stark-03/CapSight/docs/Build_Steps_3D.html

CapSight · cap camera build

# ESP32-CAM build, step by step in 3D

Each step plays as an animation. Drag to rotate, pinch or scroll to zoom, and use the slider to scrub through a step. Steps 1–4 use the parts you have now; steps 5–6 preview Phase B.

drag to rotate · scroll to zoom

◀ Prev Replay 1 / 6 Next ▶

Models are simplified and not exactly to scale. Always match the pin names printed on your own boards.
