stark-03/CapSight/docs/SRS_Camera_Navigation.pdf

SOFTWARE REQUIREMENTS SPECIFICATION · IEEE 830 STRUCTURE

# Camera-Based Navigation System for Visually Impaired People

A camera on a cap streams to an Android phone. The phone detects obstacles, estimates distance, picks a safe direction, and speaks instructions through Bluetooth earphones.

Version | 1.0 (draft for review)
Date | 29 September 2026
Institution | Dept. of CSE, Angadi Institute of Technology and Management, Belagavi (VTU)
Team | Aishwarya Kumar Telasinge (2AG23CS007) · Anuja Sutar (2AG23CS016) · Aishwarya Channashetti (2AG23CS006) · Chandrika Bannimatti (2AG23CS032)
Guide | Prof. Avanti Patil

### Supersedes Ceiling-camera + BLE design (Phase-2 report)

# 1 Introduction

## 1.1 Purpose

This document specifies the requirements for a wearable navigation aid. It is written for the project team, the project guide and the evaluators. It is the reference for design, implementation and acceptance testing.

## 1.2 Scope

The system has two parts:

Cap unit. A small camera board mounted on the front of a cap. It captures the scene in front of the user and streams it over Wi-Fi.
Android application. It receives the frames and runs all AI processing on the phone: object detection, obstacle detection, distance estimation and path analysis. It then decides a direction and speaks it through the phone speaker or Bluetooth earphones.

The system works indoors and outdoors at walking speed, with no internet connection and no building infrastructure. It supplements the white cane and does not replace it. Turn-by-turn route navigation (for example “go to Room 204”) is out of scope for this version.

## 1.3 Definitions and abbreviations

TERM | MEANING
Cap unit | The camera board, battery and optional IMU mounted on the cap.

TERM | MEANING
Walking corridor | The strip of the image directly ahead of the user, about shoulder width (0.8 m) at ground level.
Obstacle | Any object in or near the walking corridor that the user could collide with or trip over.
Zone | One of three vertical sectors of the view: left, centre, right.
Pitch | The up/down tilt of the user’s head, and therefore of the camera.
MJPEG | Motion JPEG. A video stream sent as a sequence of JPEG images over HTTP.
TFLite | TensorFlow Lite (LiteRT). The on-device inference runtime for Android.
YOLOv8n | The nano variant of the YOLOv8 object detector, already used in Phase 2.
TTS | Text-to-speech.
IMU | Inertial measurement unit (accelerometer and gyroscope), e.g. MPU6050.
Must / Should / Could | MoSCoW priority. Must is required for the demo. Should is expected but can be cut if time runs out. Could is an enhancement.

## 1.4 References

IEEE Std 830-1998, Recommended Practice for Software Requirements Specifications.
Project Phase-2 report: Bluetooth Low Energy and Surveillance Camera-based Navigation System for Visually Impaired People, AITM Belagavi, 2025–26.
Phase-2 source code: blenav/ (in particular guidance.py , egocentric.py , voice.py ) and esp32_cam_ap/ firmware.
Ultralytics YOLOv8 documentation (TFLite export). Android TextToSpeech API documentation.

# 2 Overall description

## 2.1 Product perspective

This is the third iteration of the project. Phase 2 used a fixed ceiling camera to locate the user and BLE to identify them, with processing on a laptop. Its “first-person mode” showed that a camera carried by the user works as well. This version adopts that first-person design as the main product and moves all processing onto the phone, so the user carries the whole system.

The following Phase-2 components are reused in adapted form:

Navigation policy ( guidance.decide() , 40 unit tests): ported to Kotlin with the same priority levels. Size-based distance model ( egocentric.py , 56 unit tests): object height and width tables, reused as-is.

Voice priority and cooldown rules ( voice.py ): re-implemented on Android TTS.
ESP32-CAM access-point firmware ( esp32_cam_ap.ino ): reused with the pin map changed for the new board.

## 2.2 Product functions

1. Capture the scene in front of the user from a cap-mounted camera.
2. Stream frames to the Android phone over a direct Wi-Fi link.
3. Detect known objects (people, chairs, tables, doors, vehicles, stairs and others).
4. Detect obstacles in the walking corridor, including ones the detector cannot name.
5. Estimate the distance to each obstacle in metres.
6. Analyse the path ahead and find the clearest direction.
7. Decide an instruction and a safety alert level.
8. Speak short instructions through the phone or Bluetooth earphones.

## 2.3 User classes

USER | DESCRIPTION | WHAT THEY NEED
Primary user | A blind or low-vision person. May not be able to see the phone screen at all. | Start, stop and use the system entirely by voice, touch and hardware buttons. Short, clear spoken instructions.
Helper | A family member, caregiver or instructor who sets the system up. | Pair the cap, set the user’s height and the camera angle, and adjust voice settings.
Developer / evaluator | The project team and examiners. | A debug view showing detections, distances and decisions live, plus logs.

## 2.4 Operating environment

Phone: Android 10 (API 29) or later, 4 GB RAM or more, a mid-range chipset (Snapdragon 6/7 series, Dimensity 700 or better).
Cap unit: ESP32-S3 camera board with OV2640 sensor, 2.4 GHz Wi-Fi, powered by a 3.7 V LiPo battery. Audio: the phone speaker or any Bluetooth earphones (A2DP). Open-ear or bone-conduction earphones are recommended.
Surroundings: indoor corridors, rooms and campus pathways, in daylight or normal indoor lighting.

## 2.5 Design and implementation constraints

All AI processing runs on the phone. No cloud service and no laptop in the loop.
The app is written in Kotlin with Android Studio. Models run on TensorFlow Lite with the GPU or NNAPI delegate where available.
The cap unit must be light and small enough to wear comfortably (target ≤ 100 g including battery).

## 2.6 Assumptions and dependencies

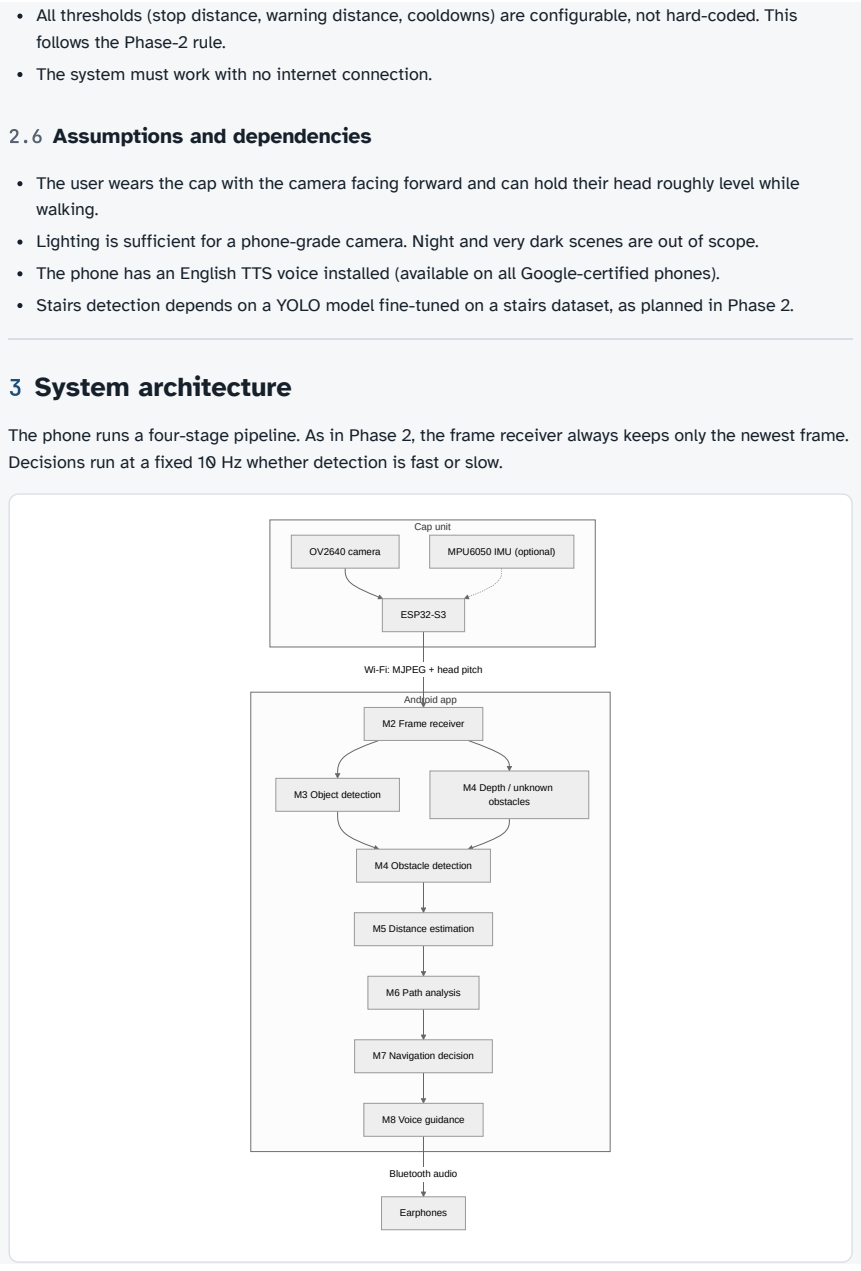
[picture p29: page 4]
3 System architecture; Android app; Cap unit; Bluetooth audio; OV2640 camera; ESP32-S3; MPU6050 IMU (optional); M2 Frame receiver; M3 Object detection; M4 Depth / unknown; obstacles; M4 Obstacle detection; M5 Distance estimation; M6 Path analysis; M7 Navigation decision; M8 Voice guidance; Earphones

All thresholds (stop distance, warning distance, cooldowns) are configurable, not hard-coded. This
follows the Phase-2 rule.
The system must work with no internet connection.

The user wears the cap with the camera facing forward and can hold their head roughly level while
walking.
Lighting is sufficient for a phone-grade camera. Night and very dark scenes are out of scope.
The phone has an English TTS voice installed (available on all Google-certified phones).
Stairs detection depends on a YOLO model fine-tuned on a stairs dataset, as planned in Phase 2.

The phone runs a four-stage pipeline. As in Phase 2, the frame receiver always keeps only the newest frame.
Decisions run at a fixed 10 Hz whether detection is fast or slow.

Wi-Fi: MJPEG + head pitch

## 3.1 Modules

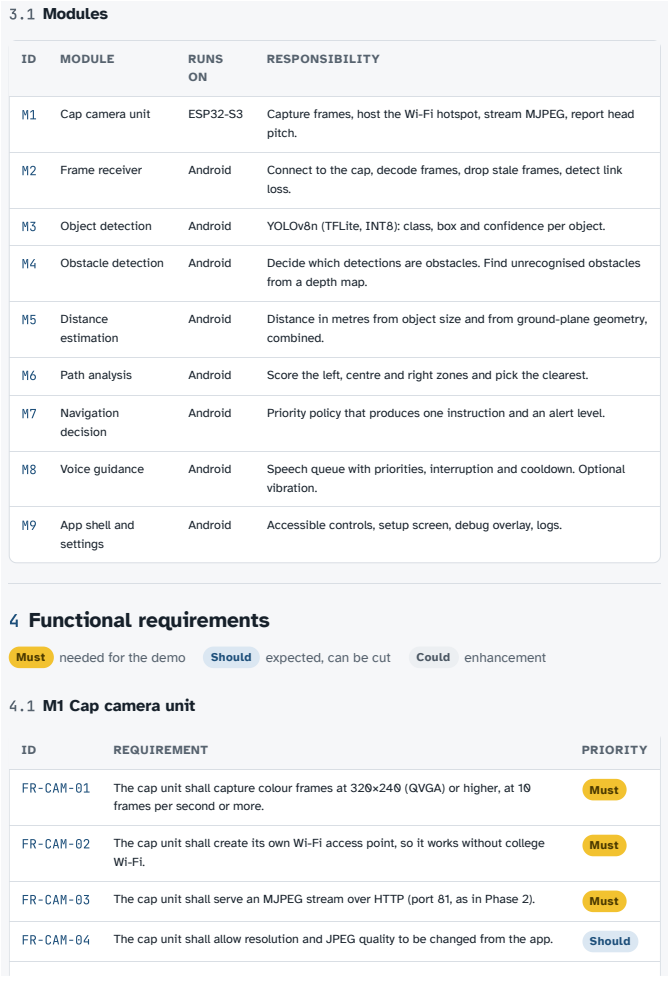
[picture p30: page 5]
MODULE; RUNS; RESPONSIBILITY; Cap camera unit; ESP32-S3; Capture frames, host the Wi-Fi hotspot, stream MJPEG, report head; pitch.; Frame receiver; Android; Connect to the cap, decode frames, drop stale frames, detect link; loss.; Object detection; YOLOv8n (TFLite, INT8): class, box and confidence per object.; Obstacle detection; Decide which detections are obstacles. Find unrecognised obstacles; Distance; estimation; Distance in metres from object size and from ground-plane geometry,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

from a depth map.

4.1 M1 Cap camera unit

frames per second or more.

## 4.2 M2 Frame receiver

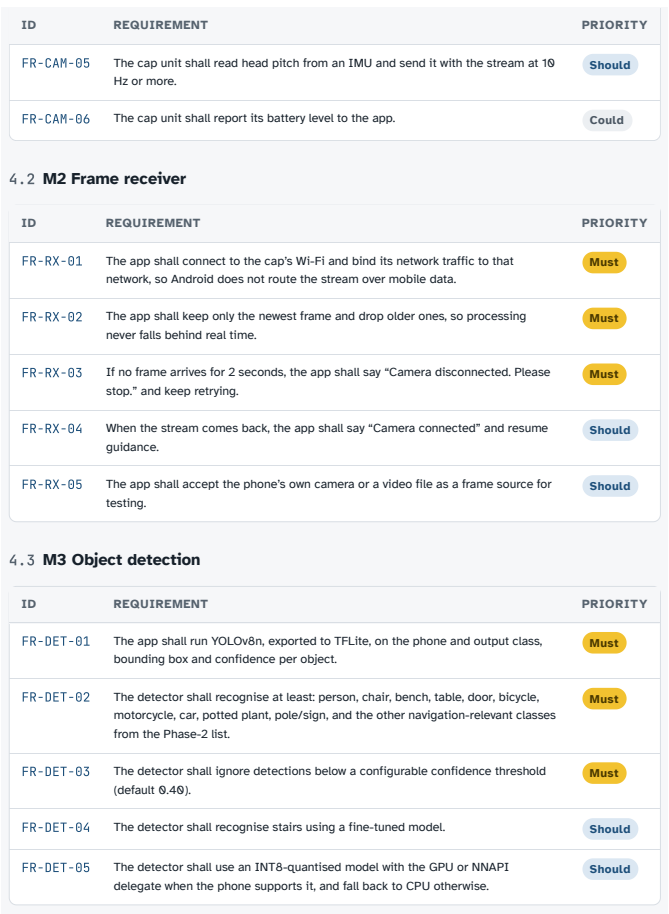
[picture p31: page 6]
REQUIREMENT; PRIORITY; FR-CAM-05; The cap unit shall read head pitch from an IMU and send it with the stream at 10; Should; FR-CAM-06; The cap unit shall report its battery level to the app.; Could; The app shall connect to the cap’s Wi-Fi and bind its network traffic to that; Must; The app shall keep only the newest frame and drop older ones, so processing; If no frame arrives for 2 seconds, the app shall say “Camera disconnected. Please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

Hz or more.

network, so Android does not route the stream over mobile data.

never falls behind real time.

stop.” and keep retrying.

bounding box and confidence per object.

motorcycle, car, potted plant, pole/sign, and the other navigation-relevant classes
from the Phase-2 list.

delegate when the phone supports it, and fall back to CPU otherwise.

## 4.4 M4 Obstacle detection

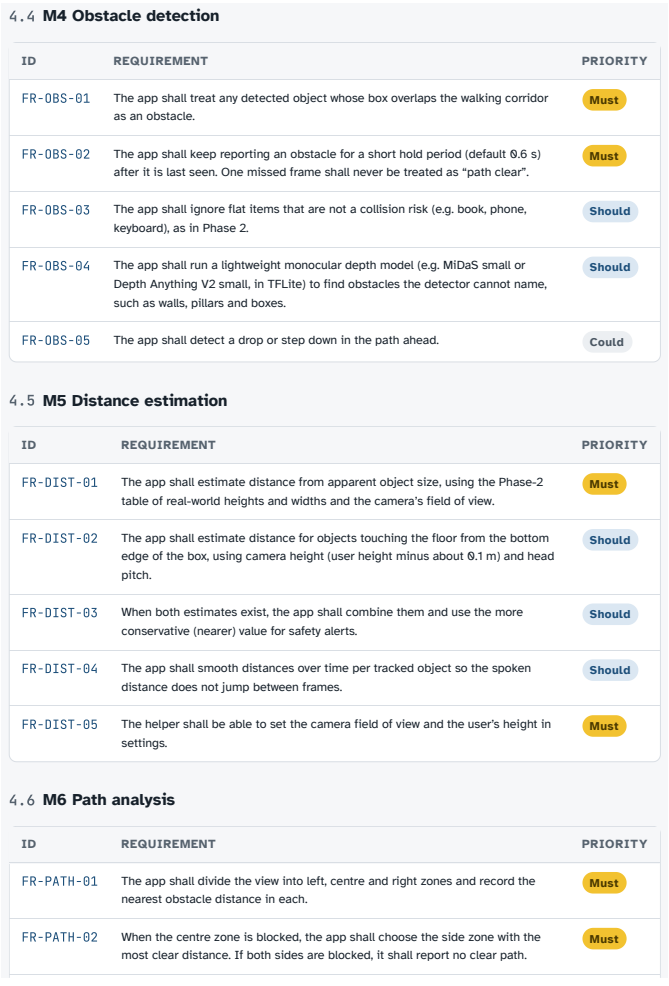
[picture p32: page 7]
REQUIREMENT; PRIORITY; FR-OBS-01; The app shall treat any detected object whose box overlaps the walking corridor; Must; FR-OBS-02; The app shall keep reporting an obstacle for a short hold period (default 0.6 s); FR-OBS-03; The app shall ignore flat items that are not a collision risk (e.g. book, phone,; Should; FR-OBS-04; The app shall run a lightweight monocular depth model (e.g. MiDaS small or; FR-OBS-05; The app shall detect a drop or step down in the path ahead.; Could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

as an obstacle.

after it is last seen. One missed frame shall never be treated as “path clear”.

keyboard), as in Phase 2.

Depth Anything V2 small, in TFLite) to find obstacles the detector cannot name,
such as walls, pillars and boxes.

table of real-world heights and widths and the camera’s field of view.

edge of the box, using camera height (user height minus about 0.1 m) and head
pitch.

conservative (nearer) value for safety alerts.

distance does not jump between frames.

nearest obstacle distance in each.

most clear distance. If both sides are blocked, it shall report no clear path.

## 4.7 M7 Navigation decision

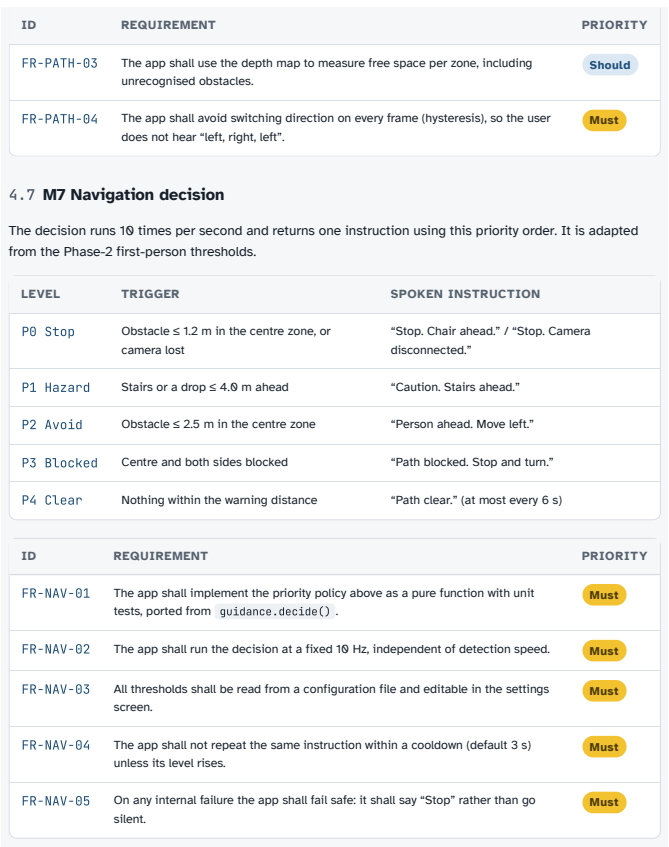
[picture p33: page 8]
REQUIREMENT; PRIORITY; FR-PATH-03; The app shall use the depth map to measure free space per zone, including; unrecognised obstacles.; Should; FR-PATH-04; The app shall avoid switching direction on every frame (hysteresis), so the user; Must; LEVEL; TRIGGER; SPOKEN INSTRUCTION; P0 Stop; Obstacle ≤ 1.2 m in the centre zone, or; camera lost; P1 Hazard; Stairs or a drop ≤ 4.0 m ahead; “Caution. Stairs ahead.”; P2 Avoid; Obstacle ≤ 2.5 m in the centre zone; “Person ahead. Move left.”; P3 Blocked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

does not hear “left, right, left”.

The decision runs 10 times per second and returns one instruction using this priority order. It is adapted
from the Phase-2 first-person thresholds.

“Stop. Chair ahead.” / “Stop. Camera
disconnected.”

tests, ported from guidance.decide() .

unless its level rises.

## 4.8 M8 Voice guidance

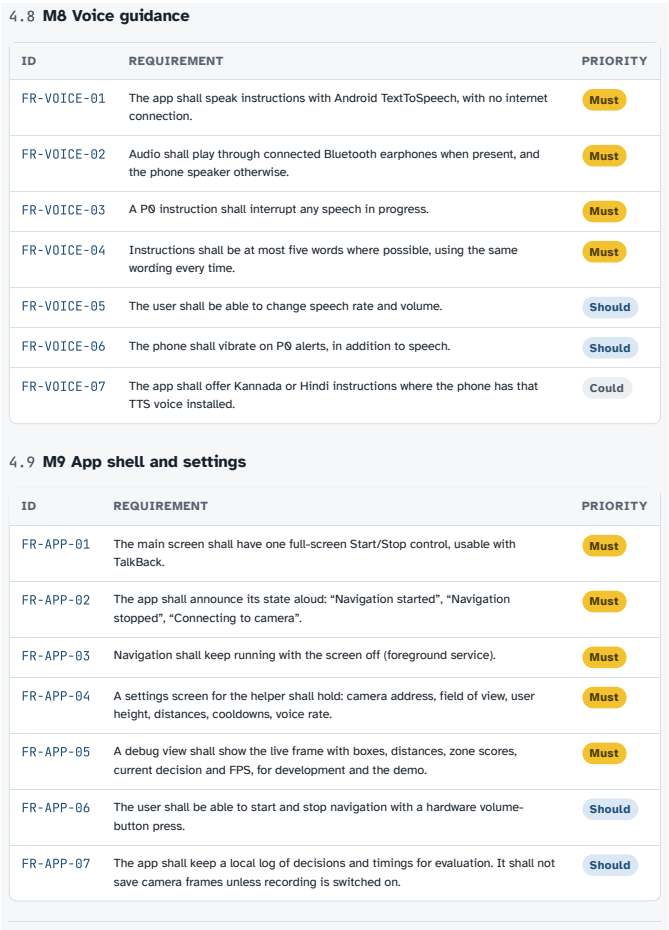
[picture p34: page 9]
REQUIREMENT; PRIORITY; FR-VOICE-01; The app shall speak instructions with Android TextToSpeech, with no internet; connection.; Must; FR-VOICE-02; Audio shall play through connected Bluetooth earphones when present, and; FR-VOICE-03; A P0 instruction shall interrupt any speech in progress.; FR-VOICE-04; Instructions shall be at most five words where possible, using the same; FR-VOICE-05; The user shall be able to change speech rate and volume.; Should; FR-VOICE-06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

the phone speaker otherwise.

wording every time.

TTS voice installed.

4.9 M9 App shell and settings

stopped”, “Connecting to camera”.

height, distances, cooldowns, voice rate.

current decision and FPS, for development and the demo.

save camera frames unless recording is switched on.

# 5 External interface requirements

## 5.1 User interface

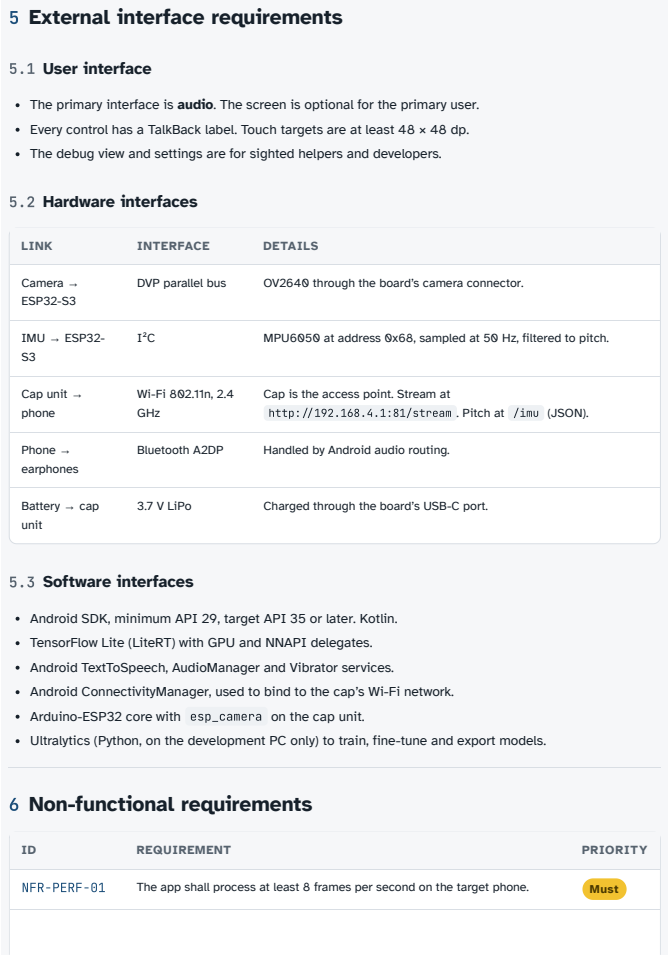
[picture p35: page 10]
5.2 Hardware interfaces; LINK; INTERFACE; DETAILS; Camera → ESP32-S3; DVP parallel bus; OV2640 through the board’s camera connector.; IMU → ESP32- S3; I²C; MPU6050 at address 0x68, sampled at 50 Hz, filtered to pitch.; Cap unit → phone; Wi-Fi 802.11n, 2.4 GHz; Phone → earphones; Bluetooth A2DP; Handled by Android audio routing.; Battery → cap unit; 3.7 V LiPo; Charged through the board’s USB-C port.; 5.3 Software interfaces; REQUIREMENT; PRIORITY; NFR-PERF-01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

The primary interface is audio. The screen is optional for the primary user.
Every control has a TalkBack label. Touch targets are at least 48 × 48 dp.
The debug view and settings are for sighted helpers and developers.

Cap is the access point. Stream at

http: /192.168.4.1:81/stream . Pitch at /imu (JSON).

Android SDK, minimum API 29, target API 35 or later. Kotlin.
TensorFlow Lite (LiteRT) with GPU and NNAPI delegates.
Android TextToSpeech, AudioManager and Vibrator services.
Android ConnectivityManager, used to bind to the cap’s Wi-Fi network.
Arduino-ESP32 core with esp_camera on the cap unit.
Ultralytics (Python, on the development PC only) to train, fine-tune and export models.

6 Non-functional requirements

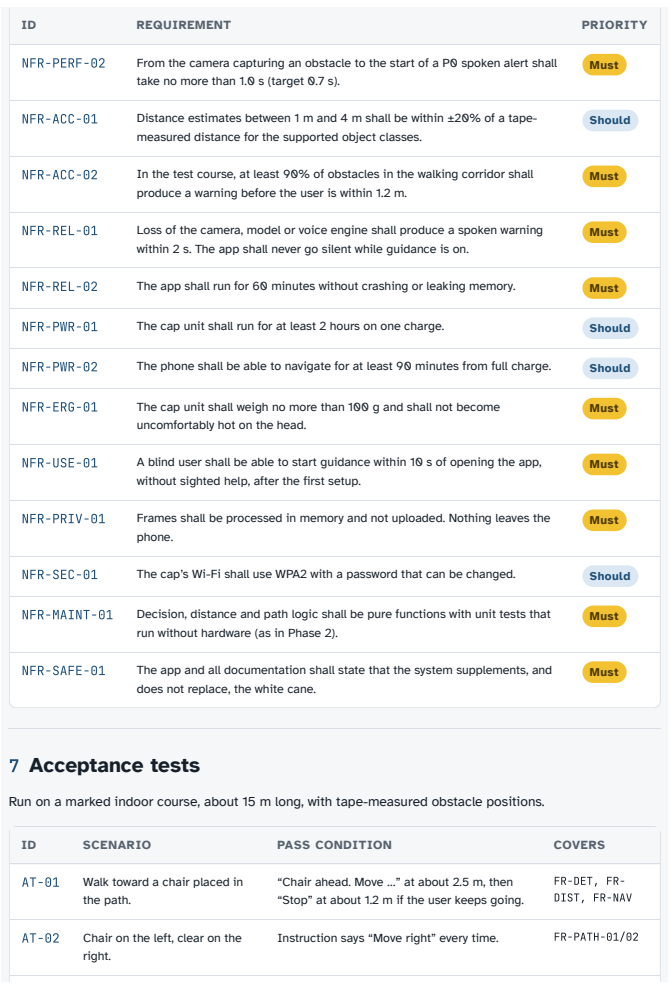
[picture p36: page 11]
REQUIREMENT; PRIORITY; NFR-PERF-02; From the camera capturing an obstacle to the start of a P0 spoken alert shall; Must; NFR-ACC-01; Distance estimates between 1 m and 4 m shall be within ±20% of a tape-; Should; NFR-ACC-02; In the test course, at least 90% of obstacles in the walking corridor shall; NFR-REL-01; Loss of the camera, model or voice engine shall produce a spoken warning; NFR-REL-02; The app shall run for 60 minutes without crashing or leaking memory.; NFR-PWR-01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

take no more than 1.0 s (target 0.7 s).

measured distance for the supported object classes.

produce a warning before the user is within 1.2 m.

within 2 s. The app shall never go silent while guidance is on.

uncomfortably hot on the head.

without sighted help, after the first setup.

run without hardware (as in Phase 2).

does not replace, the white cane.

Run on a marked indoor course, about 15 m long, with tape-measured obstacle positions.

“Chair ahead. Move …” at about 2.5 m, then
“Stop” at about 1.2 m if the user keeps going.

FR-DET, FR-

DIST, FR-NAV

ID | SCENARIO | PASS CONDITION | COVERS
AT-03 | A person walks across the path. | Warning before they are within 1.2 m. No “Path clear” while they are in the corridor. | FR-OBS-02
AT-04 | Approach a staircase. | “Caution. Stairs ahead.” at 3 m or more. | FR-DET-04
AT-05 | Approach a plain wall or a cardboard box. | Warning from the depth model before 1.2 m. | FR-OBS-04
AT-06 | Switch off the cap unit while walking.

“Camera disconnected. Please stop.” within 2 s.

FR-RX-03, NFR-

REL-01

AT-07 Connect Bluetooth earphones mid-run.

Speech moves to the earphones with no restart.

FR-VOICE-02

AT-08 Measure latency with a flashing marker in view.

Capture-to-speech ≤ 1.0 s over 20 trials. | NFR-PERF-02
AT-09 | Distance check: objects at 1, 2,
3 and 4 m.
Within ±20% for at least 80% of readings. | NFR-ACC-01
AT-10 | A blindfolded tester starts the app and walks the course.

Starts without help. Completes the course
with no collisions.

NFR-USE-01

# 8 Traceability to the stated requirements

GIVEN REQUIREMENT | MODULE | REQUIREMENT IDS
Camera mounted on cap | M1 | FR-CAM-01…06, NFR-ERG-01
Captures the user’s surroundings | M1 | FR-CAM-01, FR-CAM-03
Android mobile application | M2, M9 | FR-RX-*, FR-APP-*
Receives camera frames and processes images | M2 | FR-RX-01…05
AI-based image processing | M3–M6 | FR-DET, FR-OBS, FR-DIST, FR- PATH
Object detection | M3 | FR-DET-01…05
Obstacle detection | M4 | FR-OBS-01…05
Distance estimation | M5 | FR-DIST-01…05
Path analysis | M6 | FR-PATH-01…04
Navigation decision module | M7 | FR-NAV-01…05

GIVEN REQUIREMENT | MODULE | REQUIREMENT IDS
Determines direction and generates safety alerts | M6, M7 | FR-PATH-02, FR-NAV-01, FR-NAV-
| | 05
Voice guidance | M8 | FR-VOICE-01…07
Spoken instructions through phone or Bluetooth earphones | M8 | FR-VOICE-02

# 9 Open issues and assumptions to confirm

This draft assumes the answers below. Change them here if the team decides otherwise.

QUESTION | | ASSUMED IN THIS DRAFT
Where does image processing run? | On the Android phone (native Kotlin app, TFLite). No laptop.
Which camera goes on the cap? | An ESP32-S3 camera board (XIAO ESP32S3 Sense). The existing ESP32-
| | CAM is a budget fallback.

What happens to BLE and the
ceiling camera?

Removed from this version. Kept in the report as the previous design and as a comparison.

Minimum path analysis? | Three-zone (left/centre/right) analysis is required. Full depth-based free
space is “Should”.
Language of instructions? | English required. Kannada/Hindi optional.

# A Appendix A: Hardware to buy

Prices are approximate Indian online prices (Robu.in, Amazon.in and similar) and will vary by seller. Check stock before ordering.

## A.1 Required

ITEM | WHY | QTY | APPROX. ₹
Seeed Studio XIAO ESP32S3 Sense (with OV2640 camera) | Thumb-sized camera board with 8 MB PSRAM and a faster chip than the ESP32-CAM. It has USB-C and a built-in LiPo charger, so no separate programmer or charging board is needed. Best fit for a cap.
1 1,400–1,800

ITEM | WHY | QTY | APPROX. ₹
3.7 V LiPo battery, 1000–1200 mAh, with JST connector | Powers the cap unit for 2–3 hours. Charged through the XIAO’s USB-C port.

1 300–450

Small stick-on
heatsink
(aluminium, ~10
mm)

The XIAO Sense gets warm when streaming continuously. It sits against the user’s head.

1–2 | 30–80
Mini slide switch | Power on/off without unplugging the battery.

2 20–40

Plain baseball cap
with a stiff front
panel

Mount for the camera. A stiff peak keeps the camera angle stable.

1 200–400

Enclosure: 3Dprinted case or
small ABS project
box, plus Velcro
and zip ties

Holds the board and battery. Must leave the camera clear and allow airflow.

1 200–500

Bluetooth
earphones, open-ear or bone-conduction
preferred

Bone-conduction leaves the ears open to traffic and voices, which matters for a blind user. Ordinary Bluetooth earbuds work for testing.

1 1,500–3,500 (bone) · 800–1,500 (earbuds)

Jumper wires, thin
silicone wire, small
perfboard, heatshrink
Wiring the IMU and switch. | 1 set | 150–300

## A.2 Recommended

ITEM | WHY | QTY | APPROX. ₹
MPU6050 IMU module (GY-521) | Measures head tilt. Needed for ground-plane distance (FR-DIST-02). Without it, distance relies on object size only.
1 120–250

Wide-angle OV2640
camera, 120°–160° lens
(24-pin, fits XIAO)

Wider view catches obstacles to the sides. Only switch if the standard lens proves too narrow. Wide lenses distort, so the FOV setting must change too.

1 250–450

Spare LiPo battery | Swap during long test sessions and on demo day. | 1 | 300–450

## A.3 Optional

ITEM | WHY | QTY | APPROX. ₹
VL53L1X time-of-flight distance sensor (up to 4 m) | A true distance reading straight ahead. It covers plain walls that the camera may miss. Adds wiring and firmware work, so only if time allows.

1 600–1,000

ESP32-CAM-MB
programmer board

Only if you use the existing AI-Thinker ESP32-CAM as a backup camera. The XIAO does not need it.

1 150–250

## A.4 Do not buy

Raspberry Pi or Jetson Nano. All processing runs on the phone, so a separate computer adds weight, cost and power with no benefit.
A new phone. Use a team member’s phone that meets section 2.4.
HC-SR04 ultrasonic sensors. They are 5 V, bulky on a cap, and noisy. Use the VL53L1X if you want a range sensor.

## A.5 Budget summary

KIT | CONTENTS | APPROX. ₹
Minimum | A.1 with ordinary Bluetooth earbuds | 3,100–5,100
Recommended | A.1 with bone-conduction earphones, plus A.2 | 4,500–8,200
Recommended + optional | Above, plus VL53L1X | 5,100–9,200

Budget route with the existing ESP32-CAM
If you already own the AI-Thinker ESP32-CAM from Phase 2, you can skip the XIAO. You then need an ESP32-CAM-MB programmer, a TP4056 charger board and an MT3608 5 V boost board (or a small power bank in a pocket with a cable to the cap). Expect a bulkier, heavier cap unit and a lower frame rate. The firmware in esp32_cam_ap/ runs on it unchanged. For the XIAO, only the camera pin map in that firmware needs changing.
