stark-03/CapSight/(commit log)

2026-10-02 M2: add tools/fake_esp32cam.py, laptop stand-in for the ESP32-CAM
    Reproduces device contract v1 (CLAUDE.md §4.1-4.2): port 80 landing page
    byte-for-byte, 404 for other paths, port 81 /stream with the firmware's
    boundary, per-frame headers, no leading boundary, chunked transfer
    encoding, one client at a time, newest-frame-only. Sources: video file,
    webcam or a synthetic test card. Supports FR-RX-05 testing in Phase A.
2026-10-02 M2 FR-RX-01: MJPEG parser for the ESP32-CAM stream + JVM tests
    Reads headers to the blank line, then exactly Content-Length bytes, so the
    first frame without a leading boundary (contract §4.2) parses correctly.
    Tests use app/src/test/resources/sample.mjpeg recorded from
    tools/fake_esp32cam.py (76 VGA frames) plus synthetic edge cases:
    truncation, missing/garbage Content-Length, boundary bytes inside JPEG.
2026-10-02 M2 FR-RX-03: link monitor, FPS meter and camera contract helpers
    LinkMonitor turns frame arrival times into CONNECTING / CONNECTED /
    DISCONNECTED (no frame for 2 s, FR-RX-03; reconnect counted, FR-RX-04).
    CameraContract holds the §4 constants, derives probe/stream URLs from the
    configurable base URL and judges the §4.1 health probe. All pure Kotlin
    with JVM tests.
2026-10-02 M2 FR-RX-01/02/05: frame sources, Wi-Fi binding, health probe, cleartext config
    - CameraNetwork: requestNetwork(TRANSPORT_WIFI, no INTERNET) and
    per-connection binding, works on API 24+ (CLAUDE.md §6.3)
    - MjpegFrameSource: health probe on port 80, stream on port 81 through
    the bound network, 2 s timeouts, 500 ms retries (§4.3)
    - PhoneCameraSource (CameraX, own lifecycle owner, keep-only-latest) and
    VideoFileSource (real-time looping playback) for Phase-A testing
    - FrameReceiver: newest frame only via StateFlow (FR-RX-02), 2 s
    watchdog (FR-RX-03), restarts failed sources
    - network_security_config: cleartext only to 192.168.4.1 in release;
    debug builds allow any host so the fake ca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
2026-10-02 M2 FR-APP-05 (camera part): debug screen with live frames, FPS, link state
    Shows the newest frame, fps, frame size and age, and a 'Camera
    disconnected' banner after 2 s without a frame (FR-RX-03; TalkBack live
    region). Source selector (ESP32 / phone camera / video file), editable
    camera address with derived probe/stream URLs, Wi-Fi binding switch,
    video picker, camera permission request. The receiver runs in a
    ViewModel only until NavigationService takes it over in build step 7.
2026-10-02 Docs: record step-1 decisions in CLAUDE.md (§1A, §4.2, §6.1, §6.2)
    Fake camera port rule, chunked transfer encoding in the stream, CAMERA
    permission for PhoneCameraSource, debug-only cleartext override.
2026-10-02 M3 FR-DET-01/03: YOLOv8n LiteRT model + pure decoding (letterbox, NMS, labels)
    Model: ml/yolov8n.pt exported with Ultralytics 8.4.121 (format=litert,
    imgsz=320, FP32 - the new LiteRT export has no FP16 option) to
    assets/yolov8n_320_fp32.tflite. Verified on the laptop: input
    [1,3,320,320] NCHW float32, output [1,84,2100], boxes normalised 0-1,
    detections on bus.jpg match PyTorch within 2 px; loads in the LiteRT
    1.4 runtime.
    YoloDecoder handles normalised and pixel boxes, score threshold
    (FR-DET-03, default 0.40) and class filter; per-class NMS at IoU 0.45;
    Letterbox matches Ultralytics. JVM tests include the real model output
    for bus.jpg as a fixture.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
2026-10-02 M3 FR-DET-01/05, FR-APP-05: on-device YOLO with boxes in the debug view
    - YoloDetector: LiteRT 1.4.2 Interpreter, GPU delegate when on the
    compatibility list, else CPU with 4 threads (no NNAPI, §6.4); reads
    input layout/size from the model and logs tensor shapes on load (§7.2);
    memory-maps the model (noCompress tflite)
    - DetectionRunner: newest frame only, one dedicated inference thread,
    detector fps and timings; a failing frame is logged, not fatal
    - Debug view: boxes and labels over the live frame (person cyan,
    obstacles yellow), detector fps/backend/inference ms, detection list,
    switches for GPU and 'show all 80 classes' (default: navigation
    classes from §7.3); min confid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
2026-10-06 M8 FR-VOICE-01..06: speaker with single-slot priorities, cooldowns, haptics
    - SpeechArbiter (pure, port of voice.py): one pending slot, newer phrase
    replaces pending unless the pending one is more urgent, identical phrase
    suppressed within its cooldown (FR-NAV-04); 9 JVM tests
    - Speaker: Android TTS, offline English voice, audio usage
    ASSISTANCE_NAVIGATION_GUIDANCE (routes to Bluetooth earphones when
    connected, FR-VOICE-02), P0 interrupts with QUEUE_FLUSH (FR-VOICE-03),
    transient ducking focus, silent-engine detection + rebuild
    - Haptics: P0 always vibrates (FR-VOICE-06); P2 vibrates while TTS is
    down; captions always shown
    - Phrases: SRS §4.7 wording in one place (FR-VOICE-04)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
2026-10-06 M4/M5 FR-OBS-01/03, FR-DIST-01: port egocentric.py and world.py helpers
    - SizePriors: OBJECT_HEIGHTS_M / OBJECT_WIDTHS_M / UNRELIABLE_SMALL copied
    exactly from reference/blenav/egocentric.py
    - Egocentric: focalFromFov, estimateDistance with truncation (aspect) and
    frame-edge corrections, toRelative, obstacles() with confidence gate
    and flat-object skip
    - UserFrame: relativeToUser, inCorridor, freeSide (ties go right)
    - CameraFov: horizontal FOV of an upright frame from focal length and
    sensor size, accounting for the aspect crop and rotation (for the
    phone-camera test source)
    - JVM tests port the geometry sections of test_egocentric.py and
    test_world.py (31 tests); every navigati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
2026-10-06 M4/M5 FR-OBS-01, FR-DIST-01/05: distances and corridor status in the debug view
    - Perception.perceive (pure): every detection gets a distance (or none:
    unknown, flat, weak), corridor membership and a threat level
    (STOP <= 1.2 m, WARN <= 2.5 m in the 0.55 m half-width corridor)
    - Field of view per source: cap uses the 54 deg setting until measured;
    PhoneCameraSource computes its real FOV from Camera2 focal length and
    sensor size (crop + rotation aware) and stamps it on each frame;
    videos use a 65 deg default
    - NavigationSettings with the CLAUDE.md §8 defaults (FR-NAV-03)
    - Debug overlay: 'chair 0.82 2.1 m' labels, red/orange boxes for STOP/WARN
    in the corridor, FOV and its source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
2026-10-06 M7 FR-NAV-01/05, FR-OBS-02: pure decide() policy and stateful guidance tick
    - Policy.decide (pure port of guidance.decide, first-person): P0 camera
    lost / detector fault ('Stop.', FR-NAV-05) / imminent obstacle, P1
    stairs, P2 avoid with side, P3 'Path blocked. Stop and turn.' when
    centre and both side lanes are blocked, P4 'Path clear.'; silent (never
    a false all-clear) until perception is ready
    - Guidance: asymmetric dropout hold from _tick_first_person (FR-OBS-02)
    plus SideChooser hysteresis (FR-PATH-04)
    - PolicyTest ports test_guidance.py's first-person cases (18 tests);
    GuidanceTest ports the GuidanceLoop and dropout-hold sections of
    test_egocentric.py through the real perc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
2026-10-06 M7 FR-NAV-02/03/05, FR-RX-03/04: 10 Hz guidance loop speaks the decisions
    - service/GuidanceLoop: fixed-rate ticker (decisionRateHz, default 10)
    reading the newest camera and detector state; camera lost -> P0;
    detector failed or no result for the camera-lost timeout -> 'Stop.';
    silent until the detector has fresh results; a throwing tick says
    'Stop.' (FR-NAV-05); 'Camera connected.' after a reconnect (FR-RX-04)
    - All thresholds and cooldowns come from settings (FR-NAV-03)
    - Replaces step 3's temporary link announcements; debug switch
    'Speak guidance' (decide-and-show when off)
    - Debug view shows the current decision, its reason and the tick rate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
2026-10-06 M3/M5 FR-DET-02: outdoor obstacles - car, motorcycle, bus, truck, dog
    User decision (resolves CLAUDE.md open decision 1): these COCO classes
    were already detected but filtered out. Added to the navigation classes
    with size priors (car 1.50x1.80 m, motorcycle 1.10x0.80, bus and truck
    3.00x2.50, dog 0.55x0.30); widths are front/back views, so side-on views
    err nearer (safe). Tests updated: plausibility bound 4 m for outdoor
    classes, bus now kept by the navigation filter, car distance cases.
2026-10-06 M3 FR-DET-02/04: training pipeline for a separate hazard detector
    ml/hazards/: build_dataset.py builds a YOLO dataset from public data only
    (team decision): door, stairs, pole (Street light), sign (Traffic + Stop
    sign) from Open Images V7, pothole (D40) from RDD2022 India + Japan,
    fetching only the needed parts of RDD2022's 13 GB zip. Tested locally on
    a small sample (labels drawn and checked). train_hazards_colab.ipynb
    trains YOLOv8n at 320 on a Colab T4, reports per-class mAP and downloads
    best.pt; make_notebook.py keeps the notebook in sync with the script.
2026-10-15 M9 FR-APP-01/02/03/04, NFR-SAFE-01: foreground service, main screen, settings
    - NavigationService (foreground, connectedDevice + camera when the phone
    camera is the source) runs the whole pipeline so guidance continues
    with the screen off (FR-APP-03); partial wake lock + low-latency Wi-Fi
    lock; notification with a Stop action; restarts after a system kill
    - Pipeline: process-wide owner of receiver, detector, 10 Hz loop and
    speaker (moved out of the debug ViewModel); announces 'Navigation
    started', 'Connecting to camera', 'Navigation stopped' (FR-APP-02)
    - Main screen: one full-screen Start/Stop control with TalkBack labels
    and a live status line (FR-APP-01); first-run safety stat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
2026-10-24 Firmware: BLE landmark beacon (CS:<TYPE>:<LABEL>, CapSight service UUID)
    Any plain ESP32 (or the ESP32-CAM on its MB) advertises the CapSight 128-bit service UUID in the
    advertising packet and its CS:<TYPE>:<LABEL> name in the scan response, every 100 ms at +9 dBm.
    The app filters its scan on the UUID so landmarks keep working with the screen off (CLAUDE.md §4.6).
2026-10-24 App: BLE landmarks with distance, depth, landmarks-only mode, volume gestures, blind-first UI
    - BLE landmarks (§4.6): service-UUID-filtered scan, median RSSI, announce/re-arm hysteresis,
    spoken distance steps (about N metres, you are here), calibration at 1 m. Precise location is
    requested on every Android version: without it Android 12+ returns no scan results.
    - Depth (FR-OBS-04, FR-PATH-03): MiDaS runner at ~4 Hz, conservative centre stop + side blocking.
    - Distances (FR-DIST-02/03/04): phone tilt sensor ground-plane estimate fused with size,
    per-object smoothing that never delays an approaching obstacle.
    - Decision log (FR-APP-07): CSV per session, shareable from the debug view.
    -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
2026-10-24 Docs: student handover guide, CLAUDE.md decisions, bench setup
    docs/STUDENT_HANDOVER.md: install, volume gestures, beacon flashing and calibration, cap camera
    (8 MHz clock), developer guide, troubleshooting and accuracy figures. CLAUDE.md records the
    decisions and Android pitfalls found during testing. .gitignore keeps training data, runs and
    the auto-labelling downloads out of the repo.
